Hikarinaka/DKLed-codebase/Sample HCD/hcd - blade/Fire blade loop.bmp

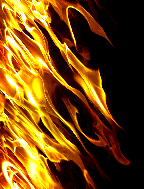
Sample HCD/hcd - blade/Fire blade loop.bmp
