Hikarinaka/DKLed-codebase/Sample HCD/hcd - blade/Fire blade start.bmp

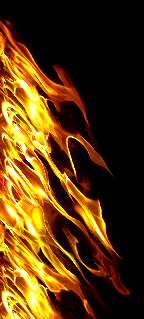
Sample HCD/hcd - blade/Fire blade start.bmp
