Hikarinaka/DKLed-codebase/Sample HCD/hcd - blade/Fire blade stop.bmp

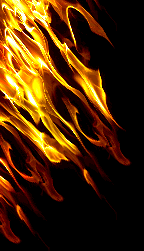
Sample HCD/hcd - blade/Fire blade stop.bmp
