Hikarinaka/DKLed-codebase/Sample HCD/hcd - blade/Fire blade.bmp

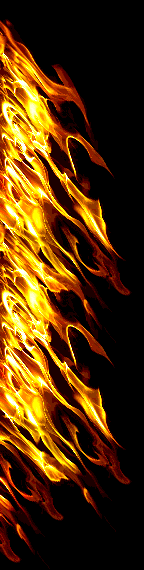
Sample HCD/hcd - blade/Fire blade.bmp
