Hikarinaka/DKLed-codebase/Software/Datasheets/NX3224K028 - Nextion_files/nextion_enhanced_2.8.jpg

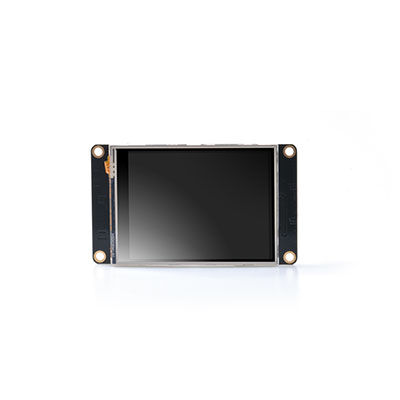
Software/Datasheets/NX3224K028 - Nextion_files/nextion_enhanced_2.8.jpg
