Hikarinaka/DKLed-codebase/Software/Datasheets/usb pinout.png

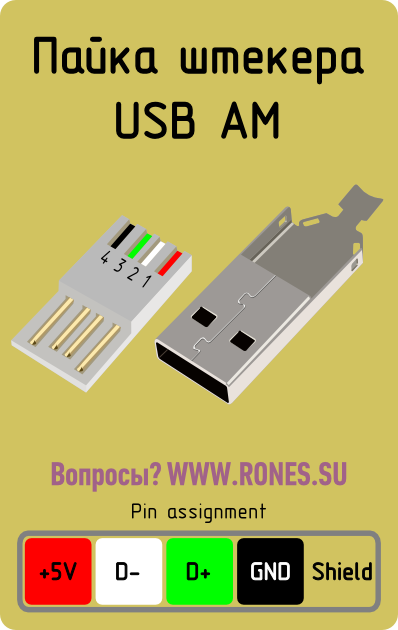
Software/Datasheets/usb pinout.png
