Hikarinaka/DKLed-codebase/Software/Datasheets/NX3224K028 - Nextion_files/Nextion_Power_Supply_Test_Board_05_2.8k.jpg

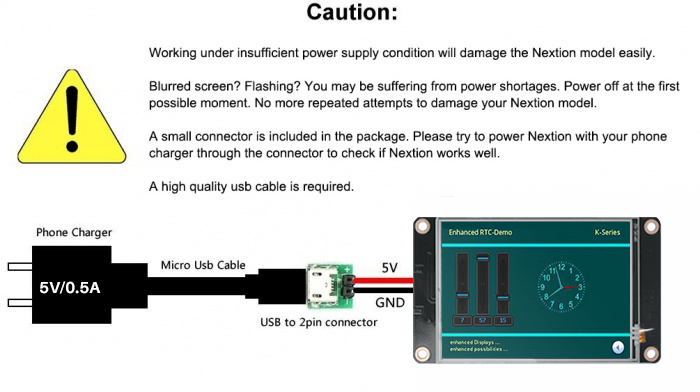
Software/Datasheets/NX3224K028 - Nextion_files/Nextion_Power_Supply_Test_Board_05_2.8k.jpg
