Hikarinaka/DKLed-codebase/(list of files, drawings)

Other design files:
Production files/DKLed_I5O8U2_v0.95-EasyEDA_JLCPcb_copy_2025-02-23.json
Production files/Sheet_1-copy_2025-02-23.schdoc
