Hikarinaka/DKLed-codebase/CooCox workspace/DKLed V0.9 - Backup 11_08_25/dbgu/I2C_c.c

#include "includes.h"
#include "stm32f10x_rcc.h"
#include "stm32f10x_i2c.h"

uint8_t i2c8; //временная переменная - счетчик
uint16_t i2c16; //временная переменная
uint8_t icc;
uint16_t ic;

uint8_t I2C_TargetAddress;//куда отправлять
uint8_t I2C_stage = 0;
//uint8_t I2C_currentStep = 0;
uint16_t I2C_sended_byte_index = 1;
uint8_t I2C_Bytes_To_Send = 0;
uint32_t I2C_eventListener;
uint8_t I2C_SelfAddress = 0; //собственный адрес контроллера
//uint16_t I2C_FailedAttemptCount = 0;
uint8_t I2C_Bytes_Recieved = 0;
uint8_t I2C_Bytes_to_Recieve = 0;
//uint8_t I2C_ByteInProcess = 0;

uint8_t I2C_tx_buff[I2C_TX_SIZE];		///< буфер передатчика uart
uint8_t I2C_rx_buf[I2C_RX_SIZE+2];

uint32_t I2C_ResetTime; //время сброса порта на случай, если он зависнет
uint32_t event = 0, flag2 = 0;

extern uint8_t ButtonFlags;
extern uint16_t DS_Pause_interrupt_Flag; //поднимаеется 0x200, если мы ждём окончания передачи данных

/* IMPORTAINT
 *
 * It seem that I2C code is sensitive to the location of operations in ROM
 * so it may be nesessary to add some dummy operations
 * like repeating same value assignment
 * */



#if (0)
void (*I2C_act[4])(uint8_t) =
	{
			I2C_START,
			I2C_SetTargetReceiver,
			I2C_SendByte,
			I2C_STOP,
	};

void I2C_START(uint8_t b){
	I2C1->CR1 |= CR1_START_Set;
	I2C_stage = 1;
}

void I2C_SetTargetReceiver(uint8_t b){
	b |= OAR1_ADD0_Set;
	I2C1->DR = b;
	I2C_stage = 2;
}

void I2C_SendByte(uint8_t b){
	I2C_stage = 3;
	if (b) {
		I2C1->DR = b;
		I2C_stage = 2;
	}
}
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
