Hikarinaka/DKLed-codebase/(commit log)

2026-05-08 Sourcecode
    Coocox source code for STM32,
    CubeMX pin mappings,
    Pyton interface project (unfinished), pixel redactor.
    Gerber files for creating the controller
    [BOM_DKLed-V0.95_2025-02-23.csv, DKLed_I5O8U2_v0.95-EasyEDA_JLCPcb_copy_2025-02-23.json, DKLed_I5O8U2_v0.95-copy_2025-02-23.dxf, PickAndPlace_combined-board_v0.95-copy_2025-02-23.csv, Sheet_1-copy_2025-02-23.schdoc]
2026-05-08 version 11 aug 2025
    Minor tweaks in I2C and deeper frequency control
